jsmercier/panama-keyboard/README.md

# panama-keyboard
Custom keyboard project using ATmega32A

Only left missing is the hex file for the QMK firmware, will add soon.
