jsmercier/panama-keyboard/DXF/mid-plate-closed.dxf

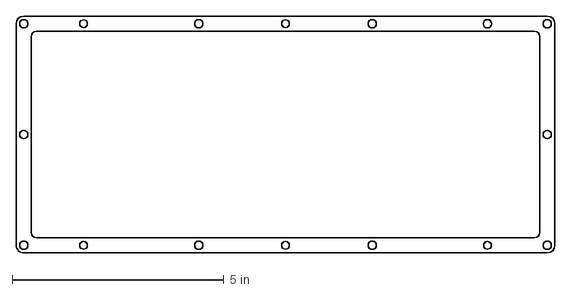
[picture p1: CAD file, 2020-08-08]
DXF/mid-plate-closed.dxf
12.7 x 5.58 in
