jsmercier/panama-keyboard/DXF/bot-plate.dxf

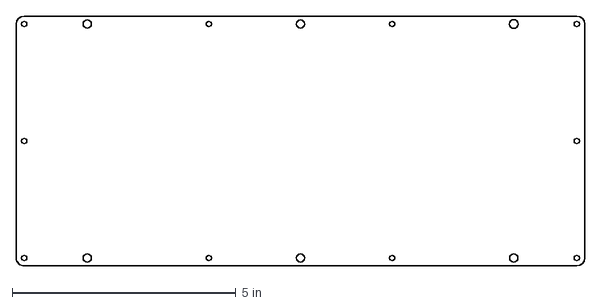
[picture p2: CAD file, 2020-08-08]
DXF/bot-plate.dxf
12.7 x 5.58 in
