jsmercier/panama-keyboard/DXF/switch-plate.dxf

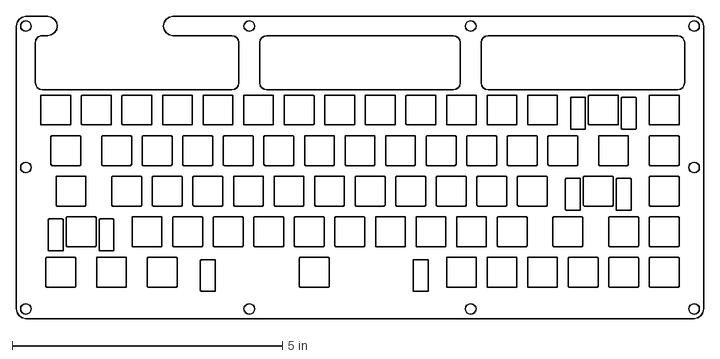
[picture p3: CAD file, 2020-08-08]
DXF/switch-plate.dxf
12.7 x 5.58 in
