jsmercier/panama-keyboard/DXF/mid-plate-open.dxf

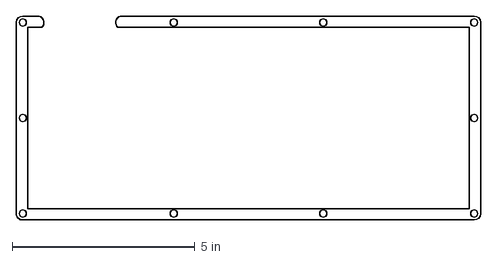
[picture p4: CAD file, 2020-08-08]
DXF/mid-plate-open.dxf
12.7 x 5.58 in
