jsmercier/panama-keyboard/DXF/top-plate-window.dxf

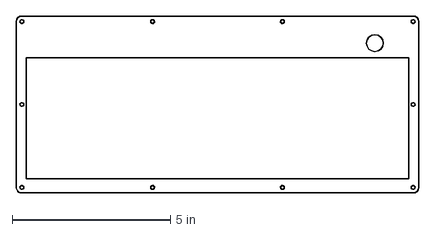
[picture p5: CAD file, 2020-08-08]
DXF/top-plate-window.dxf
12.7 x 5.58 in
