jsmercier/panama-keyboard/DXF/top-plate-spacer.dxf

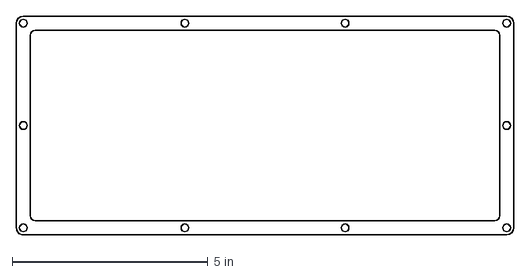
[picture p6: CAD file, 2020-08-08]
DXF/top-plate-spacer.dxf
12.7 x 5.58 in
