jsmercier/panama-keyboard/KiCad/panama-keyboard.kicad_pcb

## KiCad design KiCad/panama-keyboard.kicad_pcb (2020-08-07)

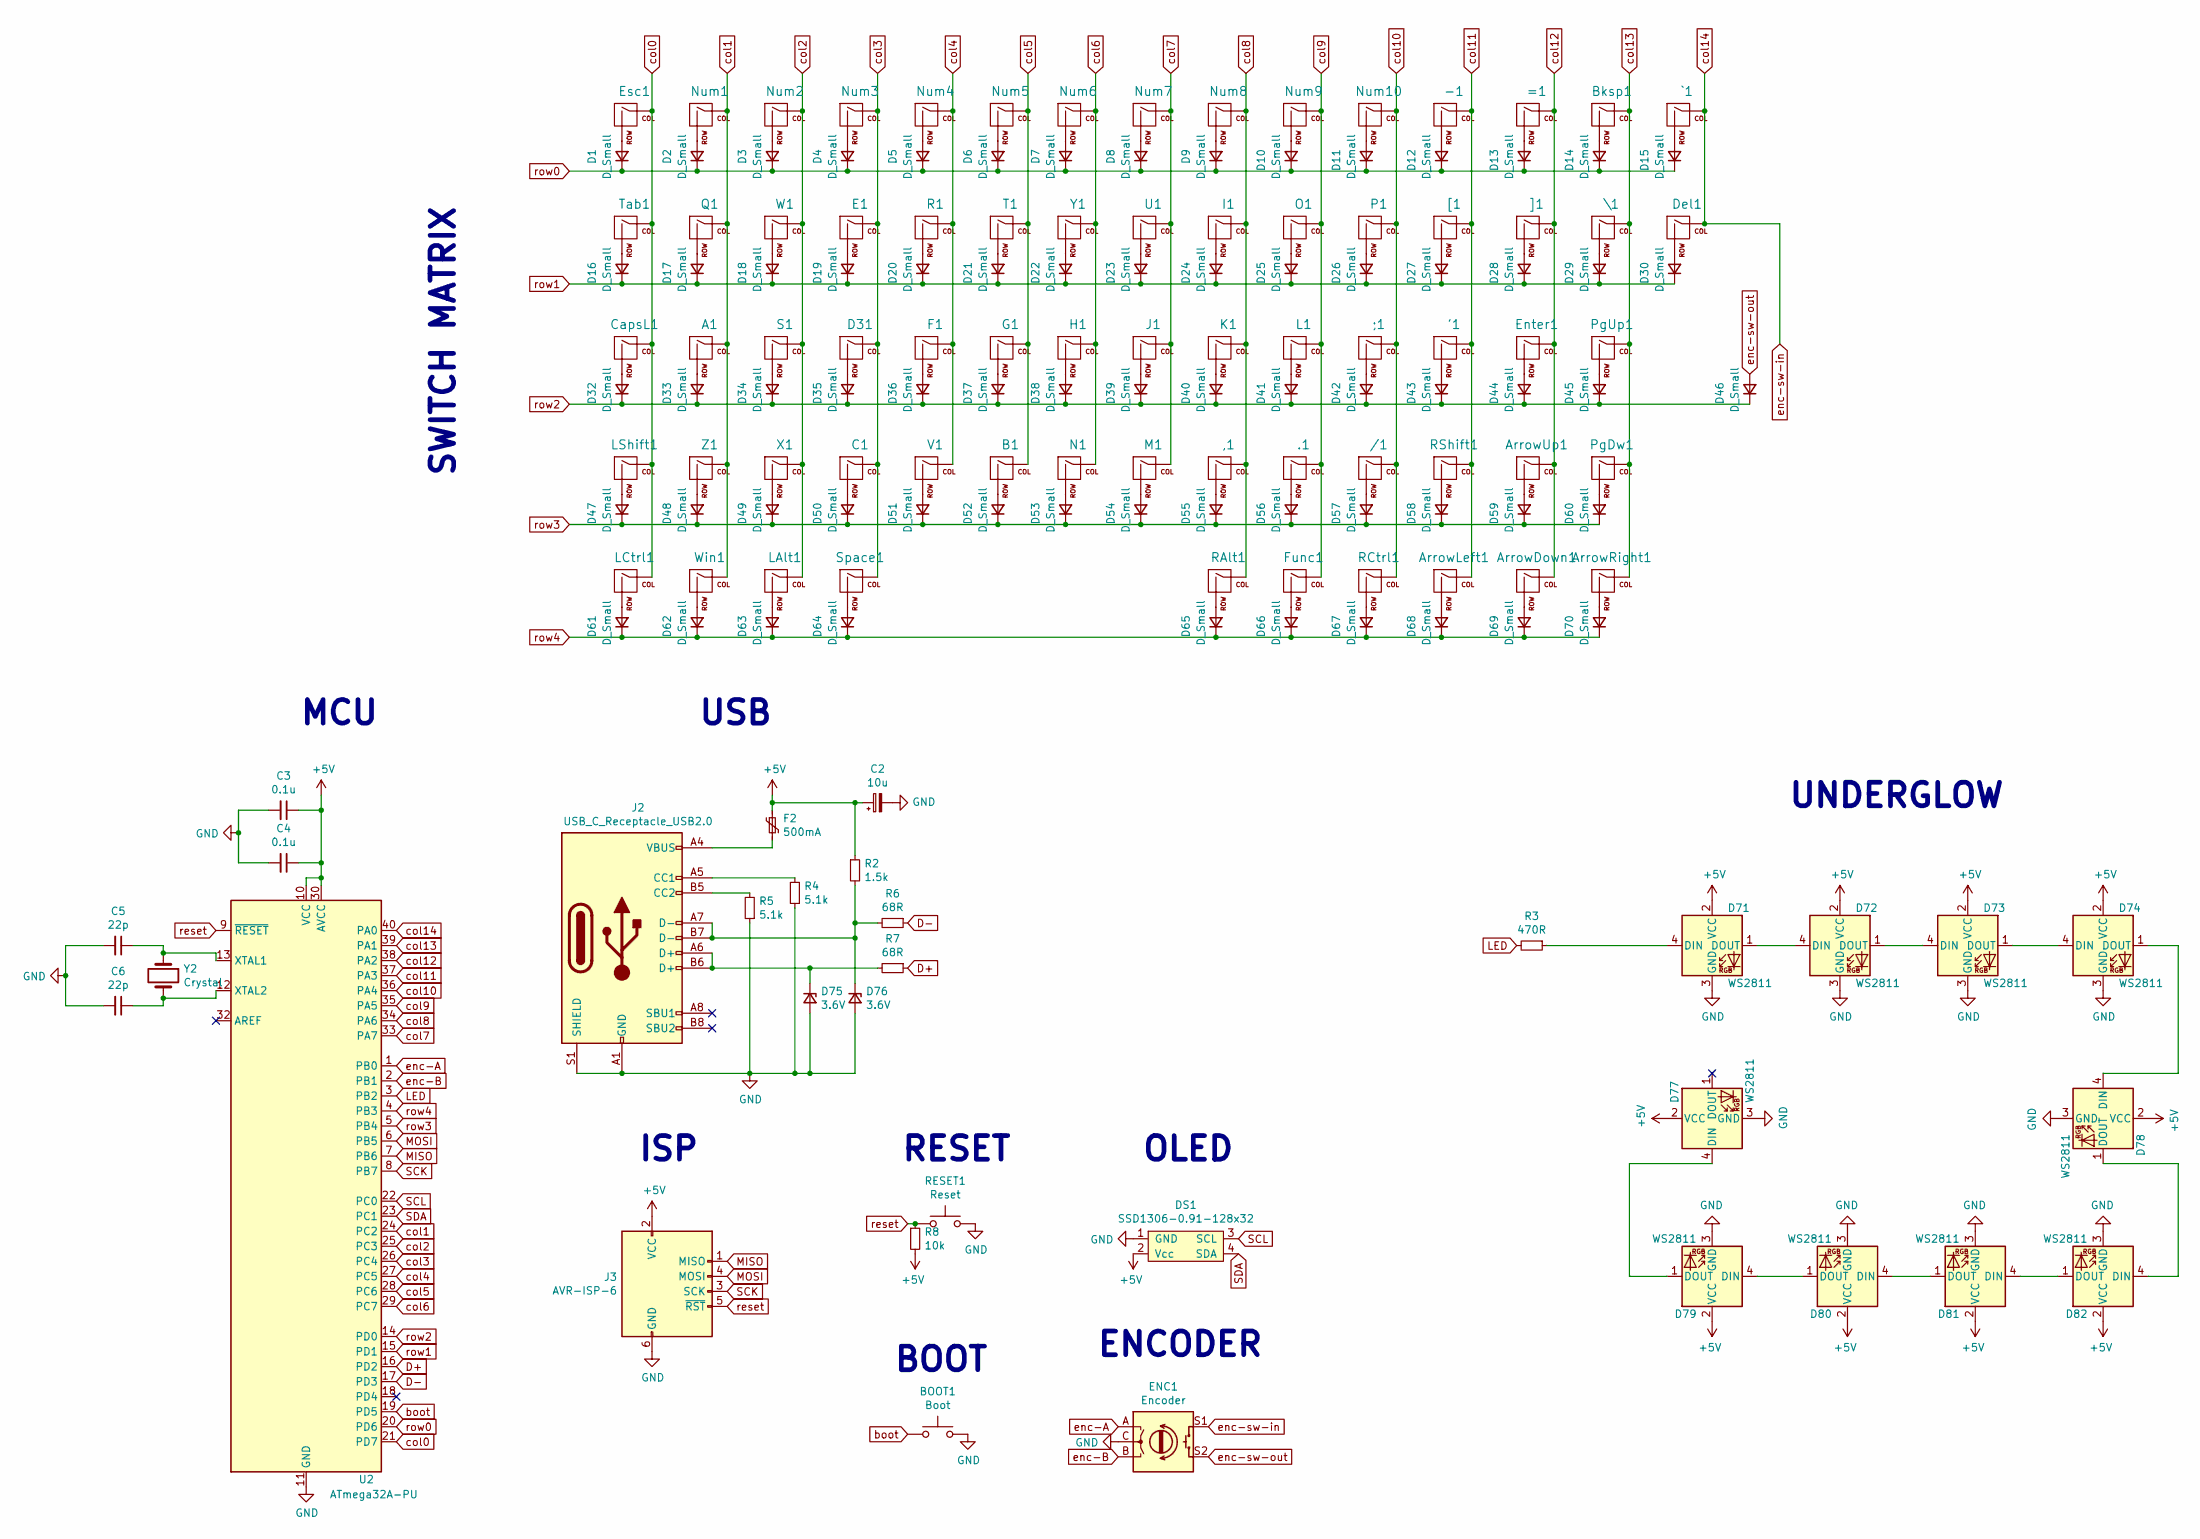
[picture p7: schematic panama-keyboard.sch, Panama Keyboard]

Parts:
'1: MX; SW_Cherry_MX_1.00u_PCB
,1: MX; SW_Cherry_MX_1.00u_PCB
-1: MX; SW_Cherry_MX_1.00u_PCB
.1: MX; SW_Cherry_MX_1.00u_PCB
/1: MX; SW_Cherry_MX_1.00u_PCB
;1: MX; SW_Cherry_MX_1.00u_PCB
=1: MX; SW_Cherry_MX_1.00u_PCB
A1: MX; SW_Cherry_MX_1.00u_PCB
ArrowDown1: MX; SW_Cherry_MX_1.00u_PCB
ArrowLeft1: MX; SW_Cherry_MX_1.00u_PCB
ArrowRight1: MX; SW_Cherry_MX_1.00u_PCB
ArrowUp1: MX; SW_Cherry_MX_1.00u_PCB
B1: MX; SW_Cherry_MX_1.00u_PCB
BOOT1: Boot; SW_PUSH_6mm
Bksp1: MX; SW_Cherry_MX_2.00u_PCB
C1: MX; SW_Cherry_MX_1.00u_PCB
C2: 10u; CP_Radial_D5.0mm_P2.00mm
C3, C4: 0.1u; C_Disc_D5.0mm_W2.5mm_P5.00mm
C5, C6: 22p; C_Disc_D5.0mm_W2.5mm_P5.00mm
CapsL1: MX; SW_Cherry_MX_1.75u_PCB
D1, D2, D3, D4, D5, D6, D7, D8, D9, D10, D11, D12, D13, D14, D15, D16, D17, D18, D19, D20, D21, D22, D23, D24, D25, D26, D27, D28, D29, D30, D32, D33, D34, D35, D36, D37, D38, D39, D40, D41, D42, D43, D44, D45, D46, D47, D48, D49, D50, D51, D52, D53, D54, D55, D56, D57, D58, D59, D60, D61, D62, D63, D64, D65, D66, D67, D68, D69, D70: D_Small; D_DO-35_SOD27_P7.62mm_Horizontal
D31: MX; SW_Cherry_MX_1.00u_PCB
D71, D72, D73, D74, D77, D78, D79, D80, D81, D82: WS2811; LED_D5.0mm-4_RGB
D75, D76: 3.6V; D_DO-35_SOD27_P7.62mm_Horizontal
DS1: SSD1306-0.91-128x32; OLED_0.91in_128x32
Del1: MX; SW_Cherry_MX_1.00u_PCB
E1: MX; SW_Cherry_MX_1.00u_PCB
ENC1: Encoder; RotaryEncoder_Alps_EC11E-Switch_Vertical_H20mm
Enter1: MX; SW_Cherry_MX_2.25u_PCB
Esc1: MX; SW_Cherry_MX_1.00u_PCB
F1: MX; SW_Cherry_MX_1.00u_PCB
F2: 500mA; Fuse_BelFuse_0ZRE0005FF_L8.3mm_W3.8mm
Func1: MX; SW_Cherry_MX_1.00u_PCB
G1: MX; SW_Cherry_MX_1.00u_PCB
H1: MX; SW_Cherry_MX_1.00u_PCB
I1: MX; SW_Cherry_MX_1.00u_PCB
J1: MX; SW_Cherry_MX_1.00u_PCB
J2: USB_C_Receptacle_USB2.0; USB_C_Receptacle_GCT_USB4085
J3: AVR-ISP-6; PinHeader_1x06_P2.54mm_Horizontal
K1: MX; SW_Cherry_MX_1.00u_PCB
L1: MX; SW_Cherry_MX_1.00u_PCB
LAlt1: MX; SW_Cherry_MX_1.25u_PCB
LCtrl1: MX; SW_Cherry_MX_1.25u_PCB
LShift1: MX; SW_Cherry_MX_2.25u_PCB
M1: MX; SW_Cherry_MX_1.00u_PCB
N1: MX; SW_Cherry_MX_1.00u_PCB
Num1, Num2, Num3, Num4, Num5, Num6, Num7, Num8, Num9, Num10: MX; SW_Cherry_MX_1.00u_PCB
O1: MX; SW_Cherry_MX_1.00u_PCB
P1: MX; SW_Cherry_MX_1.00u_PCB
PgDw1: MX; SW_Cherry_MX_1.00u_PCB
PgUp1: MX; SW_Cherry_MX_1.00u_PCB
Q1: MX; SW_Cherry_MX_1.00u_PCB
R1: MX; SW_Cherry_MX_1.00u_PCB
R2: 1.5k; R_Axial_DIN0204_L3.6mm_D1.6mm_P5.08mm_Horizontal
R3: 470R; R_Axial_DIN0204_L3.6mm_D1.6mm_P5.08mm_Horizontal
R4, R5: 5.1k; R_Axial_DIN0204_L3.6mm_D1.6mm_P5.08mm_Horizontal
R6, R7: 68R; R_Axial_DIN0204_L3.6mm_D1.6mm_P5.08mm_Horizontal
R8: 10k; R_Axial_DIN0204_L3.6mm_D1.6mm_P5.08mm_Horizontal
RAlt1: MX; SW_Cherry_MX_1.00u_PCB
RCtrl1: MX; SW_Cherry_MX_1.00u_PCB
RESET1: Reset; SW_PUSH_6mm
RShift1: MX; SW_Cherry_MX_1.75u_PCB
S1: MX; SW_Cherry_MX_1.00u_PCB
Space1: MX; SW_Cherry_MX_6.25u_PCB
T1: MX; SW_Cherry_MX_1.00u_PCB
Tab1: MX; SW_Cherry_MX_1.50u_PCB
U1: MX; SW_Cherry_MX_1.00u_PCB
U2: ATmega32A-PU; DIP-40_W15.24mm_Socket
V1: MX; SW_Cherry_MX_1.00u_PCB
W1: MX; SW_Cherry_MX_1.00u_PCB
Win1: MX; SW_Cherry_MX_1.25u_PCB
X1: MX; SW_Cherry_MX_1.00u_PCB
Y1: MX; SW_Cherry_MX_1.00u_PCB
Y2: Crystal; Crystal_HC49-U_Vertical
Z1: MX; SW_Cherry_MX_1.00u_PCB
[1: MX; SW_Cherry_MX_1.00u_PCB
\1: MX; SW_Cherry_MX_1.50u_PCB
]1: MX; SW_Cherry_MX_1.00u_PCB
`1: MX; SW_Cherry_MX_1.00u_PCB

Connections:
+5V: C2.1, C3.1, C4.1, D71.2 (VCC), D72.2 (VCC), D73.2 (VCC), D74.2 (VCC), D77.2 (VCC), D78.2 (VCC), D79.2 (VCC), D80.2 (VCC), D81.2 (VCC), D82.2 (VCC), DS1.2 (Vcc), F2.1, J3.2 (VCC), R2.1, R8.2, U2.10 (VCC), U2.30 (AVCC)
D+: R7.1, U2.16 (PD2)
D-: R6.1, U2.17 (PD3)
GND: BOOT1.2, C2.2, C3.2, C4.2, C5.2, C6.2, D71.3 (GND), D72.3 (GND), D73.3 (GND), D74.3 (GND), D75.2 (A), D76.2 (A), D77.3 (GND), D78.3 (GND), D79.3 (GND), D80.3 (GND), D81.3 (GND), D82.3 (GND), DS1.1 (GND), ENC1.C, J2.A1 (GND), J2.A12 (GND), J2.B1 (GND), J2.B12 (GND), J2.S1 (SHIELD), J3.6 (GND), R4.1, R5.1, RESET1.2, U2.11 (GND), U2.31 (GND)
LED: R3.2, U2.3 (PB2)
MISO: J3.1 (MISO), U2.7 (PB6)
MOSI: J3.4 (MOSI), U2.6 (PB5)
unnamed: '1.2 (ROW), D43.2 (A)
unnamed: ,1.2 (ROW), D55.2 (A)
unnamed: -1.2 (ROW), D12.2 (A)
unnamed: .1.2 (ROW), D56.2 (A)
unnamed: /1.2 (ROW), D57.2 (A)
unnamed: ;1.2 (ROW), D42.2 (A)
unnamed: =1.2 (ROW), D13.2 (A)
unnamed: A1.2 (ROW), D33.2 (A)
unnamed: ArrowDown1.2 (ROW), D69.2 (A)
unnamed: ArrowLeft1.2 (ROW), D68.2 (A)
unnamed: ArrowRight1.2 (ROW), D70.2 (A)
unnamed: ArrowUp1.2 (ROW), D59.2 (A)
unnamed: B1.2 (ROW), D52.2 (A)
unnamed: Bksp1.2 (ROW), D14.2 (A)
unnamed: C1.2 (ROW), D50.2 (A)
unnamed: C5.1, U2.13 (XTAL1), Y2.1
unnamed: C6.1, U2.12 (XTAL2), Y2.2
unnamed: CapsL1.2 (ROW), D32.2 (A)
unnamed: D1.2 (A), Esc1.2 (ROW)
unnamed: D2.2 (A), Num1.2 (ROW)
unnamed: D3.2 (A), Num2.2 (ROW)
unnamed: D4.2 (A), Num3.2 (ROW)
unnamed: D5.2 (A), Num4.2 (ROW)
unnamed: D6.2 (A), Num5.2 (ROW)
unnamed: D7.2 (A), Num6.2 (ROW)
unnamed: D8.2 (A), Num7.2 (ROW)
unnamed: D9.2 (A), Num8.2 (ROW)
unnamed: D10.2 (A), Num9.2 (ROW)
unnamed: D11.2 (A), Num10.2 (ROW)
unnamed: D15.2 (A), `1.2 (ROW)
unnamed: D16.2 (A), Tab1.2 (ROW)
unnamed: D17.2 (A), Q1.2 (ROW)
unnamed: D18.2 (A), W1.2 (ROW)
unnamed: D19.2 (A), E1.2 (ROW)
unnamed: D20.2 (A), R1.2 (ROW)
unnamed: D21.2 (A), T1.2 (ROW)
unnamed: D22.2 (A), Y1.2 (ROW)
unnamed: D23.2 (A), U1.2 (ROW)
unnamed: D24.2 (A), I1.2 (ROW)
unnamed: D25.2 (A), O1.2 (ROW)
unnamed: D26.2 (A), P1.2 (ROW)
unnamed: D27.2 (A), [1.2 (ROW)
unnamed: D28.2 (A), ]1.2 (ROW)
unnamed: D29.2 (A), \1.2 (ROW)
unnamed: D30.2 (A), Del1.2 (ROW)
unnamed: D31.2 (ROW), D35.2 (A)
unnamed: D34.2 (A), S1.2 (ROW)
unnamed: D36.2 (A), F1.2 (ROW)
unnamed: D37.2 (A), G1.2 (ROW)
unnamed: D38.2 (A), H1.2 (ROW)
unnamed: D39.2 (A), J1.2 (ROW)
unnamed: D40.2 (A), K1.2 (ROW)
unnamed: D41.2 (A), L1.2 (ROW)
unnamed: D44.2 (A), Enter1.2 (ROW)
unnamed: D45.2 (A), PgUp1.2 (ROW)
unnamed: D47.2 (A), LShift1.2 (ROW)
unnamed: D48.2 (A), Z1.2 (ROW)
unnamed: D49.2 (A), X1.2 (ROW)
unnamed: D51.2 (A), V1.2 (ROW)
unnamed: D53.2 (A), N1.2 (ROW)
unnamed: D54.2 (A), M1.2 (ROW)
unnamed: D58.2 (A), RShift1.2 (ROW)
unnamed: D60.2 (A), PgDw1.2 (ROW)
unnamed: D61.2 (A), LCtrl1.2 (ROW)
unnamed: D62.2 (A), Win1.2 (ROW)
unnamed: D63.2 (A), LAlt1.2 (ROW)
unnamed: D64.2 (A), Space1.2 (ROW)
unnamed: D65.2 (A), RAlt1.2 (ROW)
unnamed: D66.2 (A), Func1.2 (ROW)
unnamed: D67.2 (A), RCtrl1.2 (ROW)
unnamed: D71.1 (DOUT), D72.4 (DIN)
unnamed: D71.4 (DIN), R3.1
unnamed: D72.1 (DOUT), D73.4 (DIN)
unnamed: D73.1 (DOUT), D74.4 (DIN)
unnamed: D74.1 (DOUT), D78.4 (DIN)
unnamed: D75.1 (K), J2.A6 (D+), J2.B6 (D+), R7.2
unnamed: D76.1 (K), J2.A7 (D-), J2.B7 (D-), R2.2, R6.2
unnamed: D77.4 (DIN), D79.1 (DOUT)
unnamed: D78.1 (DOUT), D82.4 (DIN)
unnamed: D79.4 (DIN), D80.1 (DOUT)
unnamed: D80.4 (DIN), D81.1 (DOUT)
unnamed: D81.4 (DIN), D82.1 (DOUT)
unnamed: F2.2, J2.A4 (VBUS), J2.A9 (VBUS), J2.B4 (VBUS), J2.B9 (VBUS)
unnamed: J2.A5 (CC1), R4.2
unnamed: J2.B5 (CC2), R5.2
SCK: J3.3 (SCK), U2.8 (PB7)
SCL: DS1.3 (SCL), U2.22 (PC0)
SDA: DS1.4 (SDA), U2.23 (PC1)
boot: BOOT1.1, U2.19 (PD5)
col0: CapsL1.1 (COL), Esc1.1 (COL), LCtrl1.1 (COL), LShift1.1 (COL), Tab1.1 (COL), U2.21 (PD7)
col1: A1.1 (COL), Num1.1 (COL), Q1.1 (COL), U2.24 (PC2), Win1.1 (COL), Z1.1 (COL)
col2: LAlt1.1 (COL), Num2.1 (COL), S1.1 (COL), U2.25 (PC3), W1.1 (COL), X1.1 (COL)
col3: C1.1 (COL), D31.1 (COL), E1.1 (COL), Num3.1 (COL), Space1.1 (COL), U2.26 (PC4)
col4: F1.1 (COL), Num4.1 (COL), R1.1 (COL), U2.27 (PC5), V1.1 (COL)
col5: B1.1 (COL), G1.1 (COL), Num5.1 (COL), T1.1 (COL), U2.28 (PC6)
col6: H1.1 (COL), N1.1 (COL), Num6.1 (COL), U2.29 (PC7), Y1.1 (COL)
col7: J1.1 (COL), M1.1 (COL), Num7.1 (COL), U1.1 (COL), U2.33 (PA7)
col8: ,1.1 (COL), I1.1 (COL), K1.1 (COL), Num8.1 (COL), RAlt1.1 (COL), U2.34 (PA6)
col9: .1.1 (COL), Func1.1 (COL), L1.1 (COL), Num9.1 (COL), O1.1 (COL), U2.35 (PA5)
col10: /1.1 (COL), ;1.1 (COL), Num10.1 (COL), P1.1 (COL), RCtrl1.1 (COL), U2.36 (PA4)
col11: '1.1 (COL), -1.1 (COL), ArrowLeft1.1 (COL), RShift1.1 (COL), U2.37 (PA3), [1.1 (COL)
col12: =1.1 (COL), ArrowDown1.1 (COL), ArrowUp1.1 (COL), Enter1.1 (COL), U2.38 (PA2), ]1.1 (COL)
col13: ArrowRight1.1 (COL), Bksp1.1 (COL), PgDw1.1 (COL), PgUp1.1 (COL), U2.39 (PA1), \1.1 (COL)
col14: Del1.1 (COL), ENC1.S1, U2.40 (PA0), `1.1 (COL)
enc-A: ENC1.A, U2.1 (PB0)
enc-B: ENC1.B, U2.2 (PB1)
enc-sw-out: D46.2 (A), ENC1.S2
reset: J3.5 (~RST), R8.1, RESET1.1, U2.9 (~RESET)
row0: D1.1 (K), D2.1 (K), D3.1 (K), D4.1 (K), D5.1 (K), D6.1 (K), D7.1 (K), D8.1 (K), D9.1 (K), D10.1 (K), D11.1 (K), D12.1 (K), D13.1 (K), D14.1 (K), D15.1 (K), U2.20 (PD6)
row1: D16.1 (K), D17.1 (K), D18.1 (K), D19.1 (K), D20.1 (K), D21.1 (K), D22.1 (K), D23.1 (K), D24.1 (K), D25.1 (K), D26.1 (K), D27.1 (K), D28.1 (K), D29.1 (K), D30.1 (K), U2.15 (PD1)
row2: D32.1 (K), D33.1 (K), D34.1 (K), D35.1 (K), D36.1 (K), D37.1 (K), D38.1 (K), D39.1 (K), D40.1 (K), D41.1 (K), D42.1 (K), D43.1 (K), D44.1 (K), D45.1 (K), D46.1 (K), U2.14 (PD0)
row3: D47.1 (K), D48.1 (K), D49.1 (K), D50.1 (K), D51.1 (K), D52.1 (K), D53.1 (K), D54.1 (K), D55.1 (K), D56.1 (K), D57.1 (K), D58.1 (K), D59.1 (K), D60.1 (K), U2.5 (PB4)
row4: D61.1 (K), D62.1 (K), D63.1 (K), D64.1 (K), D65.1 (K), D66.1 (K), D67.1 (K), D68.1 (K), D69.1 (K), D70.1 (K), U2.4 (PB3)

Notes on the sheet:
SWITCH MATRIX
UNDERGLOW
BOOT
RESET
OLED
ENCODER
ISP
USB
MCU

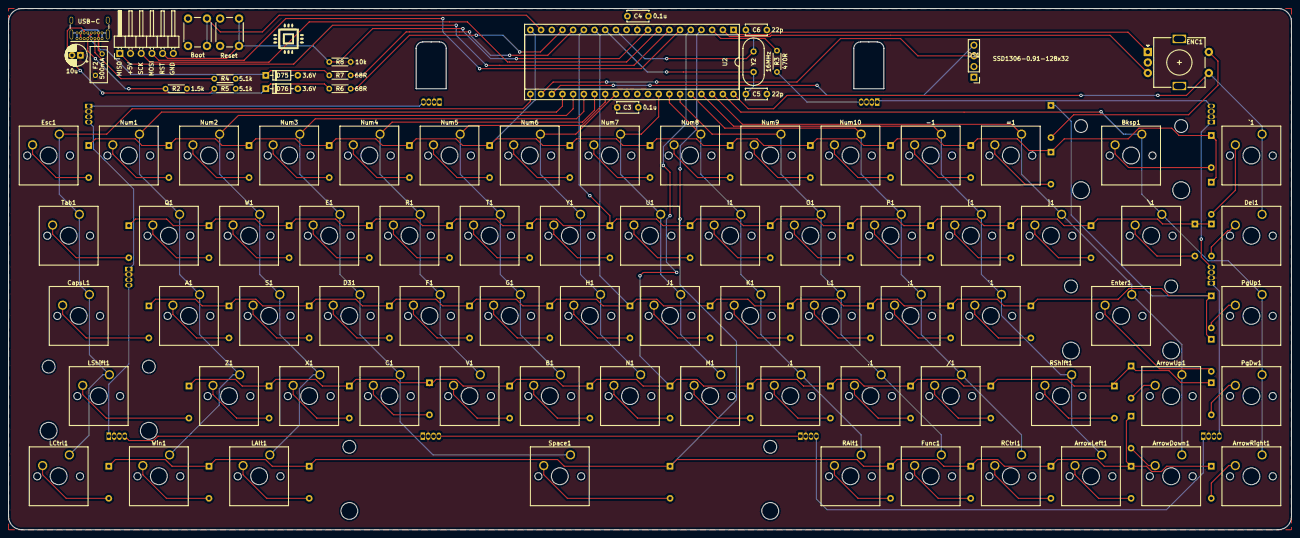
[picture p8: board panama-keyboard.kicad_pcb from above]

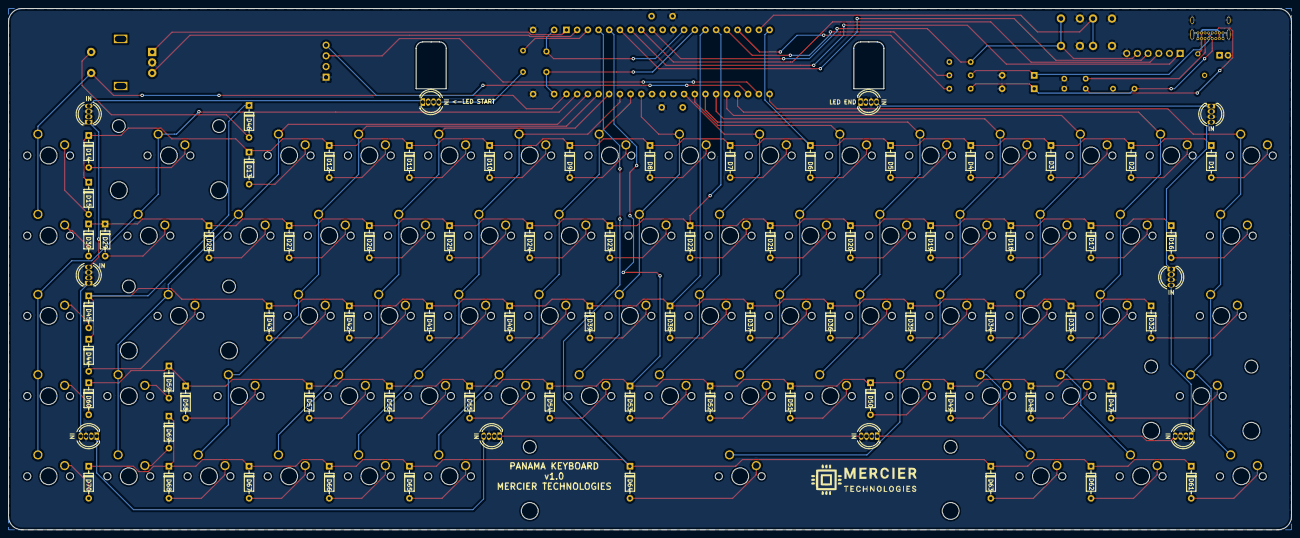
[picture p9: board panama-keyboard.kicad_pcb from below]

Board: 2 copper layers, 304.8 x 123.8 mm, 170 parts (79 on the bottom side), 120 nets.
