jsmercier/panama-keyboard/QMK_firmware/panama/config.h

/*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
You should have received a copy of the GNU General Public License
along with this program.  If not, see <http://www.gnu.org/licenses/>.
*/

#pragma once

#include "config_common.h"

#define VENDOR_ID       0x0001
#define PRODUCT_ID      0x0001
#define DEVICE_VER      0x0001
#define MANUFACTURER    jsmercier
#define PRODUCT         Panama
#define DESCRIPTION     65% keyboard that can be assembled with only through hole components

/* key matrix size */
#define MATRIX_ROWS 5
#define MATRIX_COLS 15

/*
 * Keyboard Matrix Assignments
 *
 * Change this to how you wired your keyboard
 * COLS: AVR pins used for columns, left to right
 * ROWS: AVR pins used for rows, top to bottom
 * DIODE_DIRECTION: COL2ROW = COL = Anode (+), ROW = Cathode (-, marked on diode)
 *                  ROW2COL = ROW = Anode (+), COL = Cathode (-, marked on diode)
 *
 */

#define MATRIX_ROW_PINS { D6, D1, D0, B4, B3 }
#define MATRIX_COL_PINS { D7, C2, C3, C4, C5, C6, C7, A7, A6, A5, A4, A3, A2, A1, A0 }
#define UNUSED_PINS

/* COL2ROW, ROW2COL*/
#define DIODE_DIRECTION COL2ROW

#define USB_MAX_POWER_CONSUMPTION 500

#define ENCODERS_PAD_A { B0 }
#define ENCODERS_PAD_B { B1 }
#define ENCODER_RESOLUTION 4
#define ENCODER_DIRECTION_FLIP
#define TAP_CODE_DELAY 10
// #define USB_POLLING_INTERVAL_MS 1
// #define F_SCL 100000L


 #define RGB_DI_PIN B2
 #ifdef RGB_DI_PIN
   #define RGBLED_NUM 10
   #define RGBLIGHT_HUE_STEP 10
   #define RGBLIGHT_SAT_STEP 17
   #define RGBLIGHT_VAL_STEP 17
   #define RGBLIGHT_LIMIT_VAL 200 /* The maximum brightness level */
   #define RGBLIGHT_SLEEP  /* If defined, the RGB lighting will be switched off when the host goes to sleep */
// /*== all animations enable ==*/
//   #define RGBLIGHT_ANIMATIONS
// /*== or choose animations ==*/
//   #define RGBLIGHT_EFFECT_BREATHING
//   #define RGBLIGHT_EFFECT_RAINBOW_MOOD
//   #define RGBLIGHT_EFFECT_RAINBOW_SWIRL
    #define RGBLIGHT_EFFECT_SNAKE
 //  #define RGBLIGHT_EFFECT_KNIGHT
//   #define RGBLIGHT_EFFECT_CHRISTMAS
//   #define RGBLIGHT_EFFECT_STATIC_GRADIENT
   #define RGBLIGHT_EFFECT_RGB_TEST
   #define RGBLIGHT_EFFECT_ALTERNATING
 #endif

#define OLED_DISPLAY_ADDRESS 0x3C


/* Debounce reduces chatter (unintended double-presses) - set 0 if debouncing is not needed */
#define DEBOUNCE 5

/* define if matrix has ghost (lacks anti-ghosting diodes) */
//#define MATRIX_HAS_GHOST

// /* Mechanical locking support. Use KC_LCAP, KC_LNUM or KC_LSCR instead in keymap */
// #define LOCKING_SUPPORT_ENABLE
// /* Locking resynchronize hack */
// #define LOCKING_RESYNC_ENABLE

/* If defined, GRAVE_ESC will always act as ESC when CTRL is held.
 * This is userful for the Windows task manager shortcut (ctrl+shift+esc).
 */
// #define GRAVE_ESC_CTRL_OVERRIDE

/*
 * Force NKRO
 *
 * Force NKRO (nKey Rollover) to be enabled by default, regardless of the saved
 * state in the bootmagic EEPROM settings. (Note that NKRO must be enabled in the
 * makefile for this to work.)
 *
 * If forced on, NKRO can be disabled via magic key (default = LShift+RShift+N)
 * until the next keyboard reset.
 *
 * NKRO may prevent your keystrokes from being detected in the BIOS, but it is
 * fully operational during normal computer usage.
 *
 * For a less heavy-handed approach, enable NKRO via magic key (LShift+RShift+N)
 * or via bootmagic (hold SPACE+N while plugging in the keyboard). Once set by
 * bootmagic, NKRO mode will always be enabled until it is toggled again during a
 * power-up.
 *
 */
//#define FORCE_NKRO

/*
 * Feature disable options
 *  These options are also useful to firmware size reduction.
 */

/* disable debug print */
//#define NO_DEBUG

/* disable print */
//#define NO_PRINT

/* disable action features */
//#define NO_ACTION_LAYER
//#define NO_ACTION_TAPPING
//#define NO_ACTION_ONESHOT
//#define NO_ACTION_MACRO
//#define NO_ACTION_FUNCTION
