jsmercier/panama-keyboard/USBaspLoader/updater/updater.asm

updater.elf:     file format elf32-avr

SYMBOL TABLE:
00000000 l    d  .text	00000000 .text
00800060 l    d  .data	00000000 .data
00000000 l    d  .stab	00000000 .stab
00000000 l    d  .stabstr	00000000 .stabstr
00000000 l    d  .comment	00000000 .comment
00000000 l    d  .note.gnu.avr.deviceinfo	00000000 .note.gnu.avr.deviceinfo
00000000 l    d  .debug_info	00000000 .debug_info
00000000 l    d  .debug_abbrev	00000000 .debug_abbrev
00000000 l    d  .debug_line	00000000 .debug_line
00000000 l    d  .debug_str	00000000 .debug_str
00000000 l    df *ABS*	00000000 updater.c
0000003e l       *ABS*	00000000 __SP_H__
0000003d l       *ABS*	00000000 __SP_L__
0000003f l       *ABS*	00000000 __SREG__
00000000 l       *ABS*	00000000 __tmp_reg__
00000001 l       *ABS*	00000000 __zero_reg__
0000009c l       .text	00000000 loop10
000000ca l       .text	00000000 loop27
00000000 l    df *ABS*	00000000 _exit.o
00000c58 l       .text	00000000 __stop_program
0000007a  w      .text	00000000 __vector_1
00800060 g     O .data	00000002 new_firmware
0000ffa0 g       *ABS*	00000000 __DATA_REGION_LENGTH__
0000007c g     F .text	0000002e do_spm
00000000 g       *ABS*	00000000 __TEXT_REGION_ORIGIN__
00000a6a g     F .text	00000012 memcpy_PF
00000054 g       .text	00000000 __trampolines_start
00000c5a g       .text	00000000 _etext
0000007a  w      .text	00000000 __vector_12
0000007a g       .text	00000000 __bad_interrupt
00000200 g       .text	00000000 usbasploader
00000c5c g       *ABS*	00000000 __data_load_end
0000007a  w      .text	00000000 __vector_6
00000054 g       .text	00000000 __trampolines_end
0000007a  w      .text	00000000 __vector_3
00000c5a g       *ABS*	00000000 __data_load_start
00000054 g       .text	00000000 __dtors_end
00000400 g       *ABS*	00000000 __LOCK_REGION_LENGTH__
0000007a  w      .text	00000000 __vector_11
00000054  w      .text	00000000 __init
00000a6a g       .text	00000000 _binary_usbasploader_raw_end
0000007a  w      .text	00000000 __vector_13
0000007a  w      .text	00000000 __vector_17
0000007a  w      .text	00000000 __vector_19
0000007a  w      .text	00000000 __vector_7
00810000 g       .data	00000000 __eeprom_end
00000000 g       .text	00000000 __vectors
00800062 g       .data	00000000 __data_end
0000086a g       *ABS*	00000000 _binary_usbasploader_raw_size
00000000  w      .text	00000000 __vector_default
0000007a  w      .text	00000000 __vector_5
000000fe g     F .text	00000102 mypgm_WRITEpage
000000d8 g     F .text	00000026 mypgm_readpage
00000400 g       *ABS*	00000000 __SIGNATURE_REGION_LENGTH__
00000054 g       .text	00000000 __ctors_start
00000060 g       .text	00000016 .hidden __do_copy_data
00000c48 g     F .text	0000000e memset
00000a7c g     F .text	000001cc main
0000007a  w      .text	00000000 __vector_4
00800060 g       *ABS*	00000000 __DATA_REGION_ORIGIN__
00000000  w      *ABS*	00000000 __heap_end
0000007a  w      .text	00000000 __vector_9
0000007a  w      .text	00000000 __vector_2
00000400 g       *ABS*	00000000 __USER_SIGNATURE_REGION_LENGTH__
0000007a  w      .text	00000000 __vector_15
00000054 g       .text	00000000 __dtors_start
00000054 g       .text	00000000 __ctors_end
0000085f  w      *ABS*	00000000 __stack
00800062 g       .data	00000000 _edata
00800062 g       .data	00000000 _end
0000007a  w      .text	00000000 __vector_8
00000c56  w      .text	00000000 .hidden exit
00010000 g       *ABS*	00000000 __EEPROM_REGION_LENGTH__
00000c56 g       .text	00000000 .hidden _exit
0000007a  w      .text	00000000 __vector_14
000000aa g     F .text	0000002e temp_do_spm
0000007a  w      .text	00000000 __vector_10
0000007a  w      .text	00000000 __vector_16
00800060 g       .data	00000000 __data_start
0000007a  w      .text	00000000 __vector_18
00000002 g       *ABS*	00000000 __FUSE_REGION_LENGTH__
00020000 g       *ABS*	00000000 __TEXT_REGION_LENGTH__
0000007a  w      .text	00000000 __vector_20



Disassembly of section .text:

00000000 <__vectors>:
   0:	29 c0       	rjmp	.+82     	; 0x54 <__ctors_end>
   2:	00 00       	nop
   4:	3a c0       	rjmp	.+116    	; 0x7a <__bad_interrupt>
   6:	00 00       	nop
   8:	38 c0       	rjmp	.+112    	; 0x7a <__bad_interrupt>
   a:	00 00       	nop
   c:	36 c0       	rjmp	.+108    	; 0x7a <__bad_interrupt>
   e:	00 00       	nop
  10:	34 c0       	rjmp	.+104    	; 0x7a <__bad_interrupt>
  12:	00 00       	nop
  14:	32 c0       	rjmp	.+100    	; 0x7a <__bad_interrupt>
  16:	00 00       	nop
  18:	30 c0       	rjmp	.+96     	; 0x7a <__bad_interrupt>
  1a:	00 00       	nop
  1c:	2e c0       	rjmp	.+92     	; 0x7a <__bad_interrupt>
  1e:	00 00       	nop
  20:	2c c0       	rjmp	.+88     	; 0x7a <__bad_interrupt>
  22:	00 00       	nop
  24:	2a c0       	rjmp	.+84     	; 0x7a <__bad_interrupt>
  26:	00 00       	nop
  28:	28 c0       	rjmp	.+80     	; 0x7a <__bad_interrupt>
  2a:	00 00       	nop
  2c:	26 c0       	rjmp	.+76     	; 0x7a <__bad_interrupt>
  2e:	00 00       	nop
  30:	24 c0       	rjmp	.+72     	; 0x7a <__bad_interrupt>
  32:	00 00       	nop
  34:	22 c0       	rjmp	.+68     	; 0x7a <__bad_interrupt>
  36:	00 00       	nop
  38:	20 c0       	rjmp	.+64     	; 0x7a <__bad_interrupt>
  3a:	00 00       	nop
  3c:	1e c0       	rjmp	.+60     	; 0x7a <__bad_interrupt>
  3e:	00 00       	nop
  40:	1c c0       	rjmp	.+56     	; 0x7a <__bad_interrupt>
  42:	00 00       	nop
  44:	1a c0       	rjmp	.+52     	; 0x7a <__bad_interrupt>
  46:	00 00       	nop
  48:	18 c0       	rjmp	.+48     	; 0x7a <__bad_interrupt>
  4a:	00 00       	nop
  4c:	16 c0       	rjmp	.+44     	; 0x7a <__bad_interrupt>
  4e:	00 00       	nop
  50:	14 c0       	rjmp	.+40     	; 0x7a <__bad_interrupt>
	...

00000054 <__ctors_end>:
  54:	11 24       	eor	r1, r1
  56:	1f be       	out	0x3f, r1	; 63
  58:	cf e5       	ldi	r28, 0x5F	; 95
  5a:	d8 e0       	ldi	r29, 0x08	; 8
  5c:	de bf       	out	0x3e, r29	; 62
  5e:	cd bf       	out	0x3d, r28	; 61

00000060 <__do_copy_data>:
  60:	10 e0       	ldi	r17, 0x00	; 0
  62:	a0 e6       	ldi	r26, 0x60	; 96
  64:	b0 e0       	ldi	r27, 0x00	; 0
  66:	ea e5       	ldi	r30, 0x5A	; 90
  68:	fc e0       	ldi	r31, 0x0C	; 12
  6a:	02 c0       	rjmp	.+4      	; 0x70 <__do_copy_data+0x10>
  6c:	05 90       	lpm	r0, Z+
  6e:	0d 92       	st	X+, r0
  70:	a2 36       	cpi	r26, 0x62	; 98
  72:	b1 07       	cpc	r27, r17
  74:	d9 f7       	brne	.-10     	; 0x6c <__do_copy_data+0xc>
  76:	02 d5       	rcall	.+2564   	; 0xa7c <main>
  78:	ee c5       	rjmp	.+3036   	; 0xc56 <_exit>

0000007a <__bad_interrupt>:
  7a:	c2 cf       	rjmp	.-124    	; 0x0 <__vectors>

0000007c <do_spm>:
      );												\
  })
#endif

#if (!(defined(BOOTLOADER_ADDRESS))) || (defined(NEW_BOOTLOADER_ADDRESS))
void do_spm(const uint32_t flash_byteaddress, const uint8_t spmcrval, const uint16_t dataword) {
  7c:	bf 92       	push	r11
  7e:	cf 92       	push	r12
  80:	df 92       	push	r13
  82:	d9 01       	movw	r26, r18
    __do_spm_Ex(flash_byteaddress, spmcrval, dataword, funcaddr___bootloader__do_spm >> 1);
  84:	ea e2       	ldi	r30, 0x2A	; 42
  86:	f8 e3       	ldi	r31, 0x38	; 56
  88:	0f 92       	push	r0
  8a:	1f 92       	push	r1
  8c:	d7 2e       	mov	r13, r23
  8e:	c6 2e       	mov	r12, r22
  90:	b8 2e       	mov	r11, r24
  92:	24 2f       	mov	r18, r20
  94:	1b 2e       	mov	r1, r27
  96:	0a 2e       	mov	r0, r26
  98:	09 95       	icall
  9a:	21 31       	cpi	r18, 0x11	; 17

0000009c <loop10>:
  9c:	f9 f7       	brne	.-2      	; 0x9c <loop10>
  9e:	1f 90       	pop	r1
  a0:	0f 90       	pop	r0
}
  a2:	df 90       	pop	r13
  a4:	cf 90       	pop	r12
  a6:	bf 90       	pop	r11
  a8:	08 95       	ret

000000aa <temp_do_spm>:
void new_do_spm(const uint32_t flash_byteaddress, const uint8_t spmcrval, const uint16_t dataword) {
    __do_spm_Ex(flash_byteaddress, spmcrval, dataword, NEW_SPM_ADDRESS >> 1);
}
#endif

void temp_do_spm(const uint32_t flash_byteaddress, const uint8_t spmcrval, const uint16_t dataword) {
  aa:	bf 92       	push	r11
  ac:	cf 92       	push	r12
  ae:	df 92       	push	r13
  b0:	d9 01       	movw	r26, r18
    __do_spm_Ex(flash_byteaddress, spmcrval, dataword, TEMP_SPM_ADDRESS >> 1);
  b2:	ea e2       	ldi	r30, 0x2A	; 42
  b4:	ff e3       	ldi	r31, 0x3F	; 63
  b6:	0f 92       	push	r0
  b8:	1f 92       	push	r1
  ba:	d7 2e       	mov	r13, r23
  bc:	c6 2e       	mov	r12, r22
  be:	b8 2e       	mov	r11, r24
  c0:	24 2f       	mov	r18, r20
  c2:	1b 2e       	mov	r1, r27
  c4:	0a 2e       	mov	r0, r26
  c6:	09 95       	icall
  c8:	21 31       	cpi	r18, 0x11	; 17

000000ca <loop27>:
  ca:	f9 f7       	brne	.-2      	; 0xca <loop27>
  cc:	1f 90       	pop	r1
  ce:	0f 90       	pop	r0
}
  d0:	df 90       	pop	r13
  d2:	cf 90       	pop	r12
  d4:	bf 90       	pop	r11
  d6:	08 95       	ret

000000d8 <mypgm_readpage>:
  
  return result;
}
#else
// replace it somehow with "memcpy_PF" in order to save some ops...
size_t mypgm_readpage(const mypgm_addr_t byteaddress,const void* buffer, const size_t bufferbytesize) {
  d8:	cf 93       	push	r28
  da:	df 93       	push	r29
  dc:	fa 01       	movw	r30, r20
  de:	e9 01       	movw	r28, r18
  size_t	result		= (bufferbytesize < SPM_PAGESIZE)?bufferbytesize:SPM_PAGESIZE;
  e0:	21 38       	cpi	r18, 0x81	; 129
  e2:	31 05       	cpc	r19, r1
  e4:	10 f0       	brcs	.+4      	; 0xea <mypgm_readpage+0x12>
  e6:	c0 e8       	ldi	r28, 0x80	; 128
  e8:	d0 e0       	ldi	r29, 0x00	; 0
  mypgm_addr_t	pageaddr	= byteaddress - (byteaddress % SPM_PAGESIZE);
  
  mymemcpy_PF((void*)buffer, (uint_farptr_t)pageaddr, result);
  ea:	ab 01       	movw	r20, r22
  ec:	bc 01       	movw	r22, r24
  ee:	40 78       	andi	r20, 0x80	; 128
  f0:	9e 01       	movw	r18, r28
  f2:	cf 01       	movw	r24, r30
  f4:	ba d4       	rcall	.+2420   	; 0xa6a <memcpy_PF>
  
  return result;
}
  f6:	ce 01       	movw	r24, r28
  f8:	df 91       	pop	r29
  fa:	cf 91       	pop	r28
  fc:	08 95       	ret

000000fe <mypgm_WRITEpage>:
#endif

#ifdef CONFIG_UPDATER_REDUCEWRITES
size_t mypgm_WRITEpage(const mypgm_addr_t byteaddress,const void* buffer, const size_t bufferbytesize, mypgm_spminterface spmfunc) {
  fe:	2f 92       	push	r2
 100:	3f 92       	push	r3
 102:	4f 92       	push	r4
 104:	5f 92       	push	r5
 106:	6f 92       	push	r6
 108:	7f 92       	push	r7
 10a:	8f 92       	push	r8
 10c:	9f 92       	push	r9
 10e:	af 92       	push	r10
 110:	bf 92       	push	r11
 112:	cf 92       	push	r12
 114:	df 92       	push	r13
 116:	ef 92       	push	r14
 118:	ff 92       	push	r15
 11a:	0f 93       	push	r16
 11c:	1f 93       	push	r17
 11e:	cf 93       	push	r28
 120:	df 93       	push	r29
  size_t	result		= (bufferbytesize < SPM_PAGESIZE)?bufferbytesize:SPM_PAGESIZE;
 122:	e9 01       	movw	r28, r18
 124:	21 38       	cpi	r18, 0x81	; 129
 126:	31 05       	cpc	r19, r1
 128:	10 f0       	brcs	.+4      	; 0x12e <mypgm_WRITEpage+0x30>
 12a:	c0 e8       	ldi	r28, 0x80	; 128
 12c:	d0 e0       	ldi	r29, 0x00	; 0
  size_t	pagesize	= result >> 1;
 12e:	4e 01       	movw	r8, r28
 130:	96 94       	lsr	r9
 132:	87 94       	ror	r8
  uint16_t	*pagedata	= (void*)buffer;
  mypgm_addr_t	pageaddr_bakup	= byteaddress - (byteaddress % SPM_PAGESIZE);
 134:	6b 01       	movw	r12, r22
 136:	7c 01       	movw	r14, r24
 138:	20 e8       	ldi	r18, 0x80	; 128
 13a:	c2 22       	and	r12, r18
 13c:	5a 01       	movw	r10, r20
  uint8_t	changed=0, needs_erase=0;
  uint16_t	deeword;
  size_t	i;
  
  // just check, if page needs a rewrite or an erase...
  for (i=0;i<pagesize;i+=1) {
 13e:	da 01       	movw	r26, r20
 140:	20 e0       	ldi	r18, 0x00	; 0
 142:	30 e0       	ldi	r19, 0x00	; 0
  size_t	pagesize	= result >> 1;
  uint16_t	*pagedata	= (void*)buffer;
  mypgm_addr_t	pageaddr_bakup	= byteaddress - (byteaddress % SPM_PAGESIZE);
  mypgm_addr_t	pageaddr	= pageaddr_bakup;
  
  uint8_t	changed=0, needs_erase=0;
 144:	60 e0       	ldi	r22, 0x00	; 0
 146:	70 e0       	ldi	r23, 0x00	; 0
  uint16_t	deeword;
  size_t	i;
  
  // just check, if page needs a rewrite or an erase...
  for (i=0;i<pagesize;i+=1) {
 148:	28 15       	cp	r18, r8
 14a:	39 05       	cpc	r19, r9
 14c:	b9 f0       	breq	.+46     	; 0x17c <mypgm_WRITEpage+0x7e>
#if (FLASHEND > 65535)
    deeword=pgm_read_word_far(pageaddr);
#else
    deeword=pgm_read_word(pageaddr);
 14e:	f6 01       	movw	r30, r12
 150:	e4 1b       	sub	r30, r20
 152:	f5 0b       	sbc	r31, r21
 154:	ea 0f       	add	r30, r26
 156:	fb 1f       	adc	r31, r27
 158:	85 91       	lpm	r24, Z+
 15a:	94 91       	lpm	r25, Z
#endif

    if (deeword != pagedata[i]) changed=1;
 15c:	ed 91       	ld	r30, X+
 15e:	fd 91       	ld	r31, X+
 160:	8e 17       	cp	r24, r30
 162:	9f 07       	cpc	r25, r31
 164:	09 f0       	breq	.+2      	; 0x168 <mypgm_WRITEpage+0x6a>
 166:	71 e0       	ldi	r23, 0x01	; 1
     *  0 ? 0 ==> 1
     * 
     * ==> /(/x * y) ==> x + /y
     */
    deeword |= ~pagedata[i];
    if ((~deeword) != 0) needs_erase=1;
 168:	e0 95       	com	r30
 16a:	f0 95       	com	r31
 16c:	8e 2b       	or	r24, r30
 16e:	9f 2b       	or	r25, r31
 170:	01 96       	adiw	r24, 0x01	; 1
 172:	09 f0       	breq	.+2      	; 0x176 <mypgm_WRITEpage+0x78>
 174:	61 e0       	ldi	r22, 0x01	; 1
  uint8_t	changed=0, needs_erase=0;
  uint16_t	deeword;
  size_t	i;
  
  // just check, if page needs a rewrite or an erase...
  for (i=0;i<pagesize;i+=1) {
 176:	2f 5f       	subi	r18, 0xFF	; 255
 178:	3f 4f       	sbci	r19, 0xFF	; 255
 17a:	e6 cf       	rjmp	.-52     	; 0x148 <mypgm_WRITEpage+0x4a>
    if ((~deeword) != 0) needs_erase=1;
      
    pageaddr+=2;
  }

  if (changed) {
 17c:	77 23       	and	r23, r23
 17e:	51 f1       	breq	.+84     	; 0x1d4 <mypgm_WRITEpage+0xd6>
 180:	18 01       	movw	r2, r16
    
    if (needs_erase) {
 182:	66 23       	and	r22, r22
 184:	39 f0       	breq	.+14     	; 0x194 <mypgm_WRITEpage+0x96>
      //do a page-erase, ATTANTION: flash only can be erased a limited number of times !
      spmfunc(pageaddr_bakup, updater_pageerasecode, 0);
 186:	20 e0       	ldi	r18, 0x00	; 0
 188:	30 e0       	ldi	r19, 0x00	; 0
 18a:	43 e0       	ldi	r20, 0x03	; 3
 18c:	c7 01       	movw	r24, r14
 18e:	b6 01       	movw	r22, r12
 190:	f8 01       	movw	r30, r16
 192:	09 95       	icall
  size_t	pagesize	= result >> 1;
  uint16_t	*pagedata	= (void*)buffer;
  mypgm_addr_t	pageaddr_bakup	= byteaddress - (byteaddress % SPM_PAGESIZE);
  mypgm_addr_t	pageaddr	= pageaddr_bakup;
  
  uint8_t	changed=0, needs_erase=0;
 194:	26 01       	movw	r4, r12
 196:	37 01       	movw	r6, r14
 198:	00 e0       	ldi	r16, 0x00	; 0
 19a:	10 e0       	ldi	r17, 0x00	; 0
    
    // from now on, the page is assumed empty !! (hopefully our code is located somewhere else!)
    // now, fill the tempoary buffer
    // ATTANTION: see comment on "do_spm" !
    pageaddr	= pageaddr_bakup;
    for (i=0;i<pagesize;i+=1) {
 19c:	08 15       	cp	r16, r8
 19e:	19 05       	cpc	r17, r9
 1a0:	89 f0       	breq	.+34     	; 0x1c4 <mypgm_WRITEpage+0xc6>
      spmfunc(pageaddr, updater_pagefillcode, pagedata[i]);
 1a2:	f5 01       	movw	r30, r10
 1a4:	21 91       	ld	r18, Z+
 1a6:	31 91       	ld	r19, Z+
 1a8:	5f 01       	movw	r10, r30
 1aa:	41 e0       	ldi	r20, 0x01	; 1
 1ac:	c3 01       	movw	r24, r6
 1ae:	b2 01       	movw	r22, r4
 1b0:	f1 01       	movw	r30, r2
 1b2:	09 95       	icall
      pageaddr+=2;
 1b4:	f2 e0       	ldi	r31, 0x02	; 2
 1b6:	4f 0e       	add	r4, r31
 1b8:	51 1c       	adc	r5, r1
 1ba:	61 1c       	adc	r6, r1
 1bc:	71 1c       	adc	r7, r1
    
    // from now on, the page is assumed empty !! (hopefully our code is located somewhere else!)
    // now, fill the tempoary buffer
    // ATTANTION: see comment on "do_spm" !
    pageaddr	= pageaddr_bakup;
    for (i=0;i<pagesize;i+=1) {
 1be:	0f 5f       	subi	r16, 0xFF	; 255
 1c0:	1f 4f       	sbci	r17, 0xFF	; 255
 1c2:	ec cf       	rjmp	.-40     	; 0x19c <mypgm_WRITEpage+0x9e>
      spmfunc(pageaddr, updater_pagefillcode, pagedata[i]);
      pageaddr+=2;
    }
    
    // so, now finally write the page to the FLASH
    spmfunc(pageaddr_bakup, updater_pagewritecode, 0);
 1c4:	20 e0       	ldi	r18, 0x00	; 0
 1c6:	30 e0       	ldi	r19, 0x00	; 0
 1c8:	45 e0       	ldi	r20, 0x05	; 5
 1ca:	c7 01       	movw	r24, r14
 1cc:	b6 01       	movw	r22, r12
 1ce:	f1 01       	movw	r30, r2
 1d0:	09 95       	icall
 1d2:	02 c0       	rjmp	.+4      	; 0x1d8 <mypgm_WRITEpage+0xda>
  } else {
    // no change - no write...
    result = 0;
 1d4:	c0 e0       	ldi	r28, 0x00	; 0
 1d6:	d0 e0       	ldi	r29, 0x00	; 0
  }
  
  
  return result;
}
 1d8:	ce 01       	movw	r24, r28
 1da:	df 91       	pop	r29
 1dc:	cf 91       	pop	r28
 1de:	1f 91       	pop	r17
 1e0:	0f 91       	pop	r16
 1e2:	ff 90       	pop	r15
 1e4:	ef 90       	pop	r14
 1e6:	df 90       	pop	r13
 1e8:	cf 90       	pop	r12
 1ea:	bf 90       	pop	r11
 1ec:	af 90       	pop	r10
 1ee:	9f 90       	pop	r9
 1f0:	8f 90       	pop	r8
 1f2:	7f 90       	pop	r7
 1f4:	6f 90       	pop	r6
 1f6:	5f 90       	pop	r5
 1f8:	4f 90       	pop	r4
 1fa:	3f 90       	pop	r3
 1fc:	2f 90       	pop	r2
 1fe:	08 95       	ret

00000200 <usbasploader>:
 200:	61 c0       	rjmp	.+194    	; 0x2c4 <usbasploader+0xc4>
 202:	00 00       	nop
 204:	a0 c0       	rjmp	.+320    	; 0x346 <usbasploader+0x146>
 206:	00 00       	nop
 208:	84 c0       	rjmp	.+264    	; 0x312 <usbasploader+0x112>
 20a:	00 00       	nop
 20c:	82 c0       	rjmp	.+260    	; 0x312 <usbasploader+0x112>
 20e:	00 00       	nop
 210:	80 c0       	rjmp	.+256    	; 0x312 <usbasploader+0x112>
 212:	00 00       	nop
 214:	7e c0       	rjmp	.+252    	; 0x312 <usbasploader+0x112>
 216:	00 00       	nop
 218:	7c c0       	rjmp	.+248    	; 0x312 <usbasploader+0x112>
 21a:	00 00       	nop
 21c:	7a c0       	rjmp	.+244    	; 0x312 <usbasploader+0x112>
 21e:	00 00       	nop
 220:	78 c0       	rjmp	.+240    	; 0x312 <usbasploader+0x112>
 222:	00 00       	nop
 224:	76 c0       	rjmp	.+236    	; 0x312 <usbasploader+0x112>
 226:	00 00       	nop
 228:	74 c0       	rjmp	.+232    	; 0x312 <usbasploader+0x112>
 22a:	00 00       	nop
 22c:	72 c0       	rjmp	.+228    	; 0x312 <usbasploader+0x112>
 22e:	00 00       	nop
 230:	70 c0       	rjmp	.+224    	; 0x312 <usbasploader+0x112>
 232:	00 00       	nop
 234:	6e c0       	rjmp	.+220    	; 0x312 <usbasploader+0x112>
 236:	00 00       	nop
 238:	6c c0       	rjmp	.+216    	; 0x312 <usbasploader+0x112>
 23a:	00 00       	nop
 23c:	6a c0       	rjmp	.+212    	; 0x312 <usbasploader+0x112>
 23e:	00 00       	nop
 240:	68 c0       	rjmp	.+208    	; 0x312 <usbasploader+0x112>
 242:	00 00       	nop
 244:	66 c0       	rjmp	.+204    	; 0x312 <usbasploader+0x112>
 246:	00 00       	nop
 248:	64 c0       	rjmp	.+200    	; 0x312 <usbasploader+0x112>
 24a:	00 00       	nop
 24c:	62 c0       	rjmp	.+196    	; 0x312 <usbasploader+0x112>
 24e:	00 00       	nop
 250:	60 c0       	rjmp	.+192    	; 0x312 <usbasploader+0x112>
 252:	00 00       	nop
 254:	ec 2d       	mov	r30, r12
 256:	fd 2d       	mov	r31, r13
 258:	b7 b6       	in	r11, 0x37	; 55
 25a:	b0 fc       	sbrc	r11, 0
 25c:	fd cf       	rjmp	.-6      	; 0x258 <usbasploader+0x58>
 25e:	27 bf       	out	0x37, r18	; 55
 260:	e8 95       	spm
 262:	b7 b6       	in	r11, 0x37	; 55
 264:	b0 fc       	sbrc	r11, 0
 266:	fd cf       	rjmp	.-6      	; 0x262 <usbasploader+0x62>
 268:	21 e1       	ldi	r18, 0x11	; 17
 26a:	b7 b6       	in	r11, 0x37	; 55
 26c:	b6 fc       	sbrc	r11, 6
 26e:	f4 cf       	rjmp	.-24     	; 0x258 <usbasploader+0x58>
 270:	08 95       	ret
 272:	09 02       	muls	r16, r25
 274:	12 00       	.word	0x0012	; ????
 276:	01 01       	movw	r0, r2
 278:	00 80       	ld	r0, Z
 27a:	32 09       	sbc	r19, r2
 27c:	04 00       	.word	0x0004	; ????
 27e:	00 00       	nop
 280:	00 00       	nop
 282:	00 00       	nop
 284:	12 01       	movw	r2, r4
 286:	10 01       	movw	r2, r0
 288:	ff 00       	.word	0x00ff	; ????
 28a:	00 08       	sbc	r0, r0
 28c:	c0 16       	cp	r12, r16
 28e:	dc 05       	cpc	r29, r12
 290:	02 01       	movw	r0, r4
 292:	01 02       	muls	r16, r17
 294:	00 01       	movw	r0, r0
 296:	0e 03       	fmul	r16, r22
 298:	55 00       	.word	0x0055	; ????
 29a:	53 00       	.word	0x0053	; ????
 29c:	42 00       	.word	0x0042	; ????
 29e:	61 00       	.word	0x0061	; ????
 2a0:	73 00       	.word	0x0073	; ????
 2a2:	70 00       	.word	0x0070	; ????
 2a4:	1c 03       	fmul	r17, r20
 2a6:	77 00       	.word	0x0077	; ????
 2a8:	77 00       	.word	0x0077	; ????
 2aa:	77 00       	.word	0x0077	; ????
 2ac:	2e 00       	.word	0x002e	; ????
 2ae:	66 00       	.word	0x0066	; ????
 2b0:	69 00       	.word	0x0069	; ????
 2b2:	73 00       	.word	0x0073	; ????
 2b4:	63 00       	.word	0x0063	; ????
 2b6:	68 00       	.word	0x0068	; ????
 2b8:	6c 00       	.word	0x006c	; ????
 2ba:	2e 00       	.word	0x002e	; ????
 2bc:	64 00       	.word	0x0064	; ????
 2be:	65 00       	.word	0x0065	; ????
 2c0:	04 03       	mulsu	r16, r20
 2c2:	09 04       	cpc	r0, r9
 2c4:	11 24       	eor	r1, r1
 2c6:	1f be       	out	0x3f, r1	; 63
 2c8:	cf e5       	ldi	r28, 0x5F	; 95
 2ca:	d8 e0       	ldi	r29, 0x08	; 8
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
 a3a:	9f bb       	out	0x1f, r25	; 31
 a3c:	8e bb       	out	0x1e, r24	; 30
 a3e:	e0 9a       	sbi	0x1c, 0	; 28
 a40:	99 27       	eor	r25, r25
 a42:	8d b3       	in	r24, 0x1d	; 29
 a44:	08 95       	ret
 a46:	26 2f       	mov	r18, r22
 a48:	e1 99       	sbic	0x1c, 1	; 28
 a4a:	fe cf       	rjmp	.-4      	; 0xa48 <_binary_usbasploader_raw_size+0x1de>
 a4c:	9f bb       	out	0x1f, r25	; 31
 a4e:	8e bb       	out	0x1e, r24	; 30
 a50:	2d bb       	out	0x1d, r18	; 29
 a52:	0f b6       	in	r0, 0x3f	; 63
 a54:	f8 94       	cli
 a56:	e2 9a       	sbi	0x1c, 2	; 28
 a58:	e1 9a       	sbi	0x1c, 1	; 28
 a5a:	0f be       	out	0x3f, r0	; 63
 a5c:	01 96       	adiw	r24, 0x01	; 1
 a5e:	08 95       	ret
 a60:	f8 94       	cli
 a62:	ff cf       	rjmp	.-2      	; 0xa62 <_binary_usbasploader_raw_size+0x1f8>
 a64:	ff 5a       	subi	r31, 0xAF	; 175
 a66:	1e 95 02 00 	call	0x440004	; 0x440004 <__TEXT_REGION_LENGTH__+0x420004>

00000a6a <memcpy_PF>:
 a6a:	fa 01       	movw	r30, r20
 a6c:	dc 01       	movw	r26, r24
 a6e:	02 c0       	rjmp	.+4      	; 0xa74 <memcpy_PF+0xa>
 a70:	05 90       	lpm	r0, Z+
 a72:	0d 92       	st	X+, r0
 a74:	21 50       	subi	r18, 0x01	; 1
 a76:	30 40       	sbci	r19, 0x00	; 0
 a78:	d8 f7       	brcc	.-10     	; 0xa70 <memcpy_PF+0x6>
 a7a:	08 95       	ret

00000a7c <main>:
#include "crccheck.c"
#endif

// #pragma GCC diagnostic ignored "-Wno-pointer-to-int-cast"
int main(void)
{
 a7c:	8f 92       	push	r8
 a7e:	9f 92       	push	r9
 a80:	af 92       	push	r10
 a82:	bf 92       	push	r11
 a84:	cf 92       	push	r12
 a86:	df 92       	push	r13
 a88:	ef 92       	push	r14
 a8a:	ff 92       	push	r15
 a8c:	0f 93       	push	r16
 a8e:	1f 93       	push	r17
 a90:	cf 93       	push	r28
 a92:	df 93       	push	r29
 a94:	cd b7       	in	r28, 0x3d	; 61
 a96:	de b7       	in	r29, 0x3e	; 62
 a98:	c0 58       	subi	r28, 0x80	; 128
 a9a:	d1 09       	sbc	r29, r1
 a9c:	0f b6       	in	r0, 0x3f	; 63
 a9e:	f8 94       	cli
 aa0:	de bf       	out	0x3e, r29	; 62
 aa2:	0f be       	out	0x3f, r0	; 63
 aa4:	cd bf       	out	0x3d, r28	; 61
    uint32_t crcval;
#endif
    size_t  i;
    uint8_t buffer[SPM_PAGESIZE];
    
    MCUCSR = 0; /* do not care about previous reset - just disable the wdt */
 aa6:	14 be       	out	0x34, r1	; 52
void wdt_disable (void)
{
	if (_SFR_IO_REG_P (_WD_CONTROL_REG))
	{
        uint8_t register temp_reg;
		__asm__ __volatile__ (
 aa8:	0f b6       	in	r0, 0x3f	; 63
 aaa:	f8 94       	cli
 aac:	a8 95       	wdr
 aae:	81 b5       	in	r24, 0x21	; 33
 ab0:	88 61       	ori	r24, 0x18	; 24
 ab2:	81 bd       	out	0x21, r24	; 33
 ab4:	11 bc       	out	0x21, r1	; 33
 ab6:	0f be       	out	0x3f, r0	; 63
    wdt_disable();
    cli();
 ab8:	f8 94       	cli
    // allow to change the firmware
    if (crcval == ((uint32_t)UPDATECRC32)) {
#endif

    // check if firmware would change...
    buffer[0]=0;
 aba:	19 82       	std	Y+1, r1	; 0x01
 abc:	20 91 60 00 	lds	r18, 0x0060	; 0x800060 <__DATA_REGION_ORIGIN__>
 ac0:	30 91 61 00 	lds	r19, 0x0061	; 0x800061 <__DATA_REGION_ORIGIN__+0x1>
      uint16_t a, b;
#if (FLASHEND > 65535)
      a=pgm_read_word_far(FULLCORRECTFLASHADDRESS(&new_firmware[i]));
      b=pgm_read_word_far(NEW_BOOTLOADER_ADDRESS+i);
#else
      a=pgm_read_word(FULLCORRECTFLASHADDRESS(&new_firmware[i]));
 ac4:	80 e0       	ldi	r24, 0x00	; 0
 ac6:	90 e7       	ldi	r25, 0x70	; 112
 ac8:	f9 01       	movw	r30, r18
 aca:	65 91       	lpm	r22, Z+
 acc:	74 91       	lpm	r23, Z
      b=pgm_read_word(NEW_BOOTLOADER_ADDRESS+i);
 ace:	fc 01       	movw	r30, r24
 ad0:	45 91       	lpm	r20, Z+
 ad2:	54 91       	lpm	r21, Z
#endif
      if (a!=b) {
 ad4:	64 17       	cp	r22, r20
 ad6:	75 07       	cpc	r23, r21
 ad8:	19 f0       	breq	.+6      	; 0xae0 <main+0x64>
	buffer[0]=1;
 ada:	81 e0       	ldi	r24, 0x01	; 1
 adc:	89 83       	std	Y+1, r24	; 0x01
	break;
 ade:	07 c0       	rjmp	.+14     	; 0xaee <main+0x72>
 ae0:	2e 5f       	subi	r18, 0xFE	; 254
 ae2:	3f 4f       	sbci	r19, 0xFF	; 255
 ae4:	02 96       	adiw	r24, 0x02	; 2
    if (crcval == ((uint32_t)UPDATECRC32)) {
#endif

    // check if firmware would change...
    buffer[0]=0;
    for (i=0;i<SIZEOF_new_firmware;i+=2) {
 ae6:	8a 36       	cpi	r24, 0x6A	; 106
 ae8:	48 e7       	ldi	r20, 0x78	; 120
 aea:	94 07       	cpc	r25, r20
 aec:	69 f7       	brne	.-38     	; 0xac8 <main+0x4c>
    }



    // need to change the firmware...
    if (buffer[0]) {
 aee:	89 81       	ldd	r24, Y+1	; 0x01
 af0:	88 23       	and	r24, r24
 af2:	09 f4       	brne	.+2      	; 0xaf6 <main+0x7a>
 af4:	93 c0       	rjmp	.+294    	; 0xc1c <main+0x1a0>
 af6:	24 e5       	ldi	r18, 0x54	; 84
 af8:	c2 2e       	mov	r12, r18
 afa:	20 e7       	ldi	r18, 0x70	; 112
 afc:	d2 2e       	mov	r13, r18
 afe:	e1 2c       	mov	r14, r1
 b00:	f1 2c       	mov	r15, r1
// replace it somehow with "memcpy_PF" in order to save some ops...
size_t mypgm_readpage(const mypgm_addr_t byteaddress,const void* buffer, const size_t bufferbytesize) {
  size_t	result		= (bufferbytesize < SPM_PAGESIZE)?bufferbytesize:SPM_PAGESIZE;
  mypgm_addr_t	pageaddr	= byteaddress - (byteaddress % SPM_PAGESIZE);
  
  mymemcpy_PF((void*)buffer, (uint_farptr_t)pageaddr, result);
 b02:	b7 01       	movw	r22, r14
 b04:	a6 01       	movw	r20, r12
 b06:	40 78       	andi	r20, 0x80	; 128
 b08:	20 e8       	ldi	r18, 0x80	; 128
 b0a:	30 e0       	ldi	r19, 0x00	; 0
 b0c:	ce 01       	movw	r24, r28
 b0e:	01 96       	adiw	r24, 0x01	; 1
 b10:	ac df       	rcall	.-168    	; 0xa6a <memcpy_PF>
    if (buffer[0]) {

      // A
      // copy the current "bootloader__do_spm" to tempoary position via std. "bootloader__do_spm"
      for (i=0;i<TEMP_SPM_BLKSIZE;i+=SPM_PAGESIZE) {
	mypgm_WRITEpage(TEMP_SPM_PAGEADR+i, buffer, mypgm_readpage(funcaddr___bootloader__do_spm+i, buffer, sizeof(buffer)), do_spm);
 b12:	c7 01       	movw	r24, r14
 b14:	b6 01       	movw	r22, r12
 b16:	64 55       	subi	r22, 0x54	; 84
 b18:	72 4f       	sbci	r23, 0xF2	; 242
 b1a:	8f 4f       	sbci	r24, 0xFF	; 255
 b1c:	9f 4f       	sbci	r25, 0xFF	; 255
 b1e:	0e e3       	ldi	r16, 0x3E	; 62
 b20:	10 e0       	ldi	r17, 0x00	; 0
 b22:	20 e8       	ldi	r18, 0x80	; 128
 b24:	30 e0       	ldi	r19, 0x00	; 0
 b26:	ae 01       	movw	r20, r28
 b28:	4f 5f       	subi	r20, 0xFF	; 255
 b2a:	5f 4f       	sbci	r21, 0xFF	; 255
 b2c:	e8 da       	rcall	.-2608   	; 0xfe <mypgm_WRITEpage>
 b2e:	80 e8       	ldi	r24, 0x80	; 128
 b30:	c8 0e       	add	r12, r24
 b32:	d1 1c       	adc	r13, r1
 b34:	e1 1c       	adc	r14, r1
 b36:	f1 1c       	adc	r15, r1
    // need to change the firmware...
    if (buffer[0]) {

      // A
      // copy the current "bootloader__do_spm" to tempoary position via std. "bootloader__do_spm"
      for (i=0;i<TEMP_SPM_BLKSIZE;i+=SPM_PAGESIZE) {
 b38:	44 e5       	ldi	r20, 0x54	; 84
 b3a:	c4 16       	cp	r12, r20
 b3c:	42 e7       	ldi	r20, 0x72	; 114
 b3e:	d4 06       	cpc	r13, r20
 b40:	e1 04       	cpc	r14, r1
 b42:	f1 04       	cpc	r15, r1
 b44:	f1 f6       	brne	.-68     	; 0xb02 <main+0x86>
 b46:	81 2c       	mov	r8, r1
 b48:	90 e7       	ldi	r25, 0x70	; 112
 b4a:	99 2e       	mov	r9, r25
 b4c:	a1 2c       	mov	r10, r1
 b4e:	b1 2c       	mov	r11, r1
 b50:	e1 2c       	mov	r14, r1
 b52:	f1 2c       	mov	r15, r1
      // B
      // start updating the firmware to "NEW_BOOTLOADER_ADDRESS" until at least "TEMP_SPM_BLKSIZE"-bytes after "NEW_SPM_ADDRESS" were written
      // therefore use the tempoary "bootloader__do_spm" (since we most probably will overwrite the default do_spm)
      for (i=0;;i+=SPM_PAGESIZE) {
#ifdef CONFIG_UPDATER_CLEANMEMCLEAR
	memset((void*)buffer, 0xff, sizeof(buffer));
 b54:	40 e8       	ldi	r20, 0x80	; 128
 b56:	50 e0       	ldi	r21, 0x00	; 0
 b58:	6f ef       	ldi	r22, 0xFF	; 255
 b5a:	70 e0       	ldi	r23, 0x00	; 0
 b5c:	ce 01       	movw	r24, r28
 b5e:	01 96       	adiw	r24, 0x01	; 1
 b60:	73 d0       	rcall	.+230    	; 0xc48 <memset>
#endif
	mymemcpy_PF((void*)buffer, (uint_farptr_t)(FULLCORRECTFLASHADDRESS(&new_firmware[i])), ((SIZEOF_new_firmware-i)>sizeof(buffer))?sizeof(buffer):(SIZEOF_new_firmware-i));
 b62:	40 91 60 00 	lds	r20, 0x0060	; 0x800060 <__DATA_REGION_ORIGIN__>
 b66:	50 91 61 00 	lds	r21, 0x0061	; 0x800061 <__DATA_REGION_ORIGIN__+0x1>
 b6a:	4e 0d       	add	r20, r14
 b6c:	5f 1d       	adc	r21, r15
 b6e:	05 2e       	mov	r0, r21
 b70:	00 0c       	add	r0, r0
 b72:	66 0b       	sbc	r22, r22
 b74:	77 0b       	sbc	r23, r23
 b76:	20 e8       	ldi	r18, 0x80	; 128
 b78:	30 e0       	ldi	r19, 0x00	; 0
 b7a:	ce 01       	movw	r24, r28
 b7c:	01 96       	adiw	r24, 0x01	; 1
 b7e:	75 df       	rcall	.-278    	; 0xa6a <memcpy_PF>
	
	mypgm_WRITEpage(NEW_BOOTLOADER_ADDRESS+i, buffer, sizeof(buffer), temp_do_spm);
 b80:	05 e5       	ldi	r16, 0x55	; 85
 b82:	10 e0       	ldi	r17, 0x00	; 0
 b84:	20 e8       	ldi	r18, 0x80	; 128
 b86:	30 e0       	ldi	r19, 0x00	; 0
 b88:	ae 01       	movw	r20, r28
 b8a:	4f 5f       	subi	r20, 0xFF	; 255
 b8c:	5f 4f       	sbci	r21, 0xFF	; 255
 b8e:	c5 01       	movw	r24, r10
 b90:	b4 01       	movw	r22, r8
 b92:	b5 da       	rcall	.-2710   	; 0xfe <mypgm_WRITEpage>
 b94:	80 e8       	ldi	r24, 0x80	; 128
 b96:	88 0e       	add	r8, r24
 b98:	91 1c       	adc	r9, r1
 b9a:	a1 1c       	adc	r10, r1
 b9c:	b1 1c       	adc	r11, r1
	
	if ((NEW_BOOTLOADER_ADDRESS+i) > (NEW_SPM_ADDRESS+TEMP_SPM_BLKSIZE)) break;
 b9e:	40 e8       	ldi	r20, 0x80	; 128
 ba0:	e4 16       	cp	r14, r20
 ba2:	42 e0       	ldi	r20, 0x02	; 2
 ba4:	f4 06       	cpc	r15, r20
 ba6:	21 f0       	breq	.+8      	; 0xbb0 <main+0x134>
      }

      // B
      // start updating the firmware to "NEW_BOOTLOADER_ADDRESS" until at least "TEMP_SPM_BLKSIZE"-bytes after "NEW_SPM_ADDRESS" were written
      // therefore use the tempoary "bootloader__do_spm" (since we most probably will overwrite the default do_spm)
      for (i=0;;i+=SPM_PAGESIZE) {
 ba8:	80 e8       	ldi	r24, 0x80	; 128
 baa:	e8 0e       	add	r14, r24
 bac:	f1 1c       	adc	r15, r1
	mymemcpy_PF((void*)buffer, (uint_farptr_t)(FULLCORRECTFLASHADDRESS(&new_firmware[i])), ((SIZEOF_new_firmware-i)>sizeof(buffer))?sizeof(buffer):(SIZEOF_new_firmware-i));
	
	mypgm_WRITEpage(NEW_BOOTLOADER_ADDRESS+i, buffer, sizeof(buffer), temp_do_spm);
	
	if ((NEW_BOOTLOADER_ADDRESS+i) > (NEW_SPM_ADDRESS+TEMP_SPM_BLKSIZE)) break;
      }
 bae:	d2 cf       	rjmp	.-92     	; 0xb54 <main+0xd8>
 bb0:	8a ee       	ldi	r24, 0xEA	; 234
 bb2:	c8 2e       	mov	r12, r24
 bb4:	85 e0       	ldi	r24, 0x05	; 5
 bb6:	d8 2e       	mov	r13, r24

      // C
      // continue writeing the new_firmware after "NEW_SPM_ADDRESS+TEMP_SPM_BLKSIZE" this time use the "new_do_spm"
      for (;i<SIZEOF_new_firmware;i+=SPM_PAGESIZE) {
#ifdef CONFIG_UPDATER_CLEANMEMCLEAR
	memset((void*)buffer, 0xff, sizeof(buffer));
 bb8:	40 e8       	ldi	r20, 0x80	; 128
 bba:	50 e0       	ldi	r21, 0x00	; 0
 bbc:	6f ef       	ldi	r22, 0xFF	; 255
 bbe:	70 e0       	ldi	r23, 0x00	; 0
 bc0:	ce 01       	movw	r24, r28
 bc2:	01 96       	adiw	r24, 0x01	; 1
 bc4:	41 d0       	rcall	.+130    	; 0xc48 <memset>
#endif
	mymemcpy_PF((void*)buffer, (uint_farptr_t)(FULLCORRECTFLASHADDRESS(&new_firmware[i])), ((SIZEOF_new_firmware-i)>sizeof(buffer))?sizeof(buffer):(SIZEOF_new_firmware-i));
 bc6:	96 01       	movw	r18, r12
 bc8:	41 e8       	ldi	r20, 0x81	; 129
 bca:	c4 16       	cp	r12, r20
 bcc:	d1 04       	cpc	r13, r1
 bce:	10 f0       	brcs	.+4      	; 0xbd4 <main+0x158>
 bd0:	20 e8       	ldi	r18, 0x80	; 128
 bd2:	30 e0       	ldi	r19, 0x00	; 0
 bd4:	40 91 60 00 	lds	r20, 0x0060	; 0x800060 <__DATA_REGION_ORIGIN__>
 bd8:	50 91 61 00 	lds	r21, 0x0061	; 0x800061 <__DATA_REGION_ORIGIN__+0x1>
 bdc:	4e 0d       	add	r20, r14
 bde:	5f 1d       	adc	r21, r15
 be0:	05 2e       	mov	r0, r21
 be2:	00 0c       	add	r0, r0
 be4:	66 0b       	sbc	r22, r22
 be6:	77 0b       	sbc	r23, r23
 be8:	ce 01       	movw	r24, r28
 bea:	01 96       	adiw	r24, 0x01	; 1
 bec:	3e df       	rcall	.-388    	; 0xa6a <memcpy_PF>

	mypgm_WRITEpage(NEW_BOOTLOADER_ADDRESS+i, buffer, sizeof(buffer), new_do_spm);
 bee:	b7 01       	movw	r22, r14
 bf0:	70 59       	subi	r23, 0x90	; 144
 bf2:	80 e0       	ldi	r24, 0x00	; 0
 bf4:	90 e0       	ldi	r25, 0x00	; 0
 bf6:	0e e3       	ldi	r16, 0x3E	; 62
 bf8:	10 e0       	ldi	r17, 0x00	; 0
 bfa:	20 e8       	ldi	r18, 0x80	; 128
 bfc:	30 e0       	ldi	r19, 0x00	; 0
 bfe:	ae 01       	movw	r20, r28
 c00:	4f 5f       	subi	r20, 0xFF	; 255
 c02:	5f 4f       	sbci	r21, 0xFF	; 255
 c04:	7c da       	rcall	.-2824   	; 0xfe <mypgm_WRITEpage>
	if ((NEW_BOOTLOADER_ADDRESS+i) > (NEW_SPM_ADDRESS+TEMP_SPM_BLKSIZE)) break;
      }

      // C
      // continue writeing the new_firmware after "NEW_SPM_ADDRESS+TEMP_SPM_BLKSIZE" this time use the "new_do_spm"
      for (;i<SIZEOF_new_firmware;i+=SPM_PAGESIZE) {
 c06:	80 e8       	ldi	r24, 0x80	; 128
 c08:	e8 0e       	add	r14, r24
 c0a:	f1 1c       	adc	r15, r1
 c0c:	40 e8       	ldi	r20, 0x80	; 128
 c0e:	c4 1a       	sub	r12, r20
 c10:	d1 08       	sbc	r13, r1
 c12:	8a e6       	ldi	r24, 0x6A	; 106
 c14:	e8 16       	cp	r14, r24
 c16:	88 e0       	ldi	r24, 0x08	; 8
 c18:	f8 06       	cpc	r15, r24
 c1a:	70 f2       	brcs	.-100    	; 0xbb8 <main+0x13c>
#if defined(UPDATECRC32)
    }
#endif

    return 0;
}
 c1c:	80 e0       	ldi	r24, 0x00	; 0
 c1e:	90 e0       	ldi	r25, 0x00	; 0
 c20:	c0 58       	subi	r28, 0x80	; 128
 c22:	df 4f       	sbci	r29, 0xFF	; 255
 c24:	0f b6       	in	r0, 0x3f	; 63
 c26:	f8 94       	cli
 c28:	de bf       	out	0x3e, r29	; 62
 c2a:	0f be       	out	0x3f, r0	; 63
 c2c:	cd bf       	out	0x3d, r28	; 61
 c2e:	df 91       	pop	r29
 c30:	cf 91       	pop	r28
 c32:	1f 91       	pop	r17
 c34:	0f 91       	pop	r16
 c36:	ff 90       	pop	r15
 c38:	ef 90       	pop	r14
 c3a:	df 90       	pop	r13
 c3c:	cf 90       	pop	r12
 c3e:	bf 90       	pop	r11
 c40:	af 90       	pop	r10
 c42:	9f 90       	pop	r9
 c44:	8f 90       	pop	r8
 c46:	08 95       	ret

00000c48 <memset>:
 c48:	dc 01       	movw	r26, r24
 c4a:	01 c0       	rjmp	.+2      	; 0xc4e <memset+0x6>
 c4c:	6d 93       	st	X+, r22
 c4e:	41 50       	subi	r20, 0x01	; 1
 c50:	50 40       	sbci	r21, 0x00	; 0
 c52:	e0 f7       	brcc	.-8      	; 0xc4c <memset+0x4>
 c54:	08 95       	ret

00000c56 <_exit>:
 c56:	f8 94       	cli

00000c58 <__stop_program>:
 c58:	ff cf       	rjmp	.-2      	; 0xc58 <__stop_program>
