jsmercier/panama-keyboard/(commit log)

2020-07-15 working issue
    [panama-keyboard.kicad_pcb, panama-keyboard.sch]
2020-07-15 removed useless sub folder
    [panama-keyboard.kicad_pcb, panama-keyboard.sch]
2020-07-16 added switch matrix and mcu
    [panama-keyboard.sch]
2020-07-19 schematic progress
    [panama-keyboard.sch]
2020-07-20 footprint added except MX
    [panama-keyboard.sch]
2020-07-22 finished w1 schematic, started PCB
    [panama-keyboard.sch]
2020-07-23 progree pcb
    [panama-keyboard.kicad_pcb, panama-keyboard.sch]
2020-07-24 pcb progress
    [panama-keyboard.kicad_pcb]
2020-07-27 pcb progress, back to 10 leds
    [panama-keyboard.kicad_pcb, panama-keyboard.sch]
2020-07-31 pcb progress, moved switch matrix
    [panama-keyboard.kicad_pcb, panama-keyboard.sch]
2020-07-31 logo added, PCB done
    [panama-keyboard.kicad_pcb]
2020-07-31 added usb c connector model
    [USB4085-GF-A.stp, panama-keyboard.kicad_pcb, switch-plate.dxf]
2020-07-31 added gerber files
    [panama-keyboard-B_Cu.gbr, panama-keyboard-B_Mask.gbr, panama-keyboard-B_Paste.gbr, panama-keyboard-B_SilkS.gbr, panama-keyboard-Edge_Cuts.gbr, panama-keyboard-F_Cu.gbr, panama-keyboard-F_Mask.gbr, panama-keyboard-F_Paste.gbr]
2020-08-01 added 3d models
    [asm_mx_asm_PCB.stp, asm_mx_asm_PLATE.stp, switch-plate-gen.dxf]
2020-08-02 pinout changed, pcb trace to be reworked
    [panama-keyboard.kicad_pcb, panama-keyboard.sch]
2020-08-03 traces removed for new pinout
    [panama-keyboard.kicad_pcb, panama-keyboard.sch]
2020-08-03 pcb rework done
    [panama-keyboard.kicad_pcb]
2020-08-03 pcb height adjust
    [panama-keyboard.kicad_pcb]
2020-08-04 organized Creo folder
    [USB4085-GF-A.stp, asm_mx_asm_PCB.stp, asm_mx_asm_PLATE.stp]
2020-08-05 3d progress
    [DSA_Keycap_CherryMX.step, EC11_Rotary_Encoder_Switched.step]
2020-08-07 silkscreen pcb update
    [panama-keyboard.kicad_pcb]
2020-08-07 removed Creo folder
    [DSA_Keycap_CherryMX.step, EC11_Rotary_Encoder_Switched.step, USB4085-GF-A.stp, asm_mx_asm_PCB.stp, asm_mx_asm_PLATE.stp, switch-plate-gen.dxf]
2020-08-08 added DXF and BoM
    [bot-plate.dxf, mid-plate-closed.dxf, mid-plate-open.dxf, switch-plate.dxf, top-plate-spacer.dxf, top-plate-window.dxf]
2020-08-08 updated gerber
    [panama-keyboard-B_Cu.gbr, panama-keyboard-B_Mask.gbr, panama-keyboard-B_Paste.gbr, panama-keyboard-B_SilkS.gbr, panama-keyboard-Edge_Cuts.gbr, panama-keyboard-F_Cu.gbr, panama-keyboard-F_Mask.gbr, panama-keyboard-F_Paste.gbr]
